pellinglab/DIY-Incubator-Dec2014/README.txt

DIY CO2 Incubator for Mammalian Cell Culture

December 2014

In this repository there are are 4 bits of code for testing and 1 piece of control code for controlling the CO2 incubator.

[OBSOLETE] Complete instructions for building and implementing the incubator are available at:
https://www.pellinglab.net/single-post/diy/DIY-CO2-Incubator-Bioreactor-for-Mammalian-Cell-Culture

[2024 UPDATE] Please note that this project is no longer being maintained, however the GitHub
repository is still available: https://github.com/pellinglab/DIY-Incubator-Dec2014

Test code:
- Test_CO2_Sensor: Simple test code for the cozir CO2 sensor
- Test_PWM_Fan_Control: Simple test code for the DC fan
- Test_Single_Relay: Simple test code for an SPDT relay switch
- Test_Two_DS18B20_Sensors: Simple test code for measuring the individual and average temperature across two DS18B20 sensors

Control Code:
- DIY_CO2_Incubator_Dec2014: Control code for the incubator once it is assembled
 
CC BY-NC-SA 4.0
Attribution-NonCommercial-ShareAlike 4.0 International
https://creativecommons.org/licenses/by-nc-sa/4.0/
Copyright (c) 2014 Pelling Lab

THIS PROJECT IS NO LONGER BEING MAINTAINED.
