pellinglab/DIY-Incubator-Dec2014/(threads)

Thread 1 (2024-07-31):

No license

vvnull, 2024-07-31:
Hello,

Please consider adding a—preferably free—software license, so that others may explicitly legally copy and modify the code.

Thank you!

pellinglab, 2024-11-17:
No problem. Done.

Closed 2024-11-17.
